GonzaloRomeroR/hexapod-robot/control/control.pdf

## Control din´amico

Se realiz´o el control din´amico del robot utilizando Simscape. El modelo completo puede observarse en la Figura 1. Los bloques trayectorias definen los perfiles de posiciones que debe seguir cada pata del robot. Cada una de las elementos(muslo, pierna y cuerpo del robot) poseen una masa y momento de inercia deteminado por las dimensiones de la estructura y ubicaciones de las masas involucradas. Se utilizan lazos PID como m´etodo de control de posici´on que pueden ser facilmente observados en la Figura 2.


Figure 1: Modelo din´amico total

1


Figure 2: Modelo din´amico de una pierna

2
