GonzaloRomeroR/hexapod-robot/dinamica/Dinamica.pdf

## Din´amica

Din´amica de forma anal´ıtica

1 | c l e a r
2 | c l c
3 | % Symbolic v a r i a b l e s
4 | syms l 1 l 2 l 3 ;
5 | syms q1 q2 q3 ;
6 | syms qd1 qd2 qd3 ;
7 | syms qdd1 qdd2 qdd3 ;
8 | syms l c 1 l c 2 l c 3 ;
9 | syms Ixx1 Ixx2 Ixx3 ;
10 | syms Iyy1 Iyy2 Iyy3 ;
11 | syms I z z 1 I z z 2 I z z 3 ;
12 | syms g ;
13 | syms m1 m2 m3;

14
15 | q = [ q1 q2 q3 ] ;
16 | qd = [ qd1 qd2 qd3 ] ;
17 | qdd = [ qdd1 qdd2 qdd3 ] ;

18
19 | % I n e r t i a
20 | % I 1 = [ Ixx1 , 0 , 0 ; 0 , Iyy1 , 0 ; 0 , 0 , I z z 1 ] ;
21 | % I 2 = [ Ixx2 , 0 , 0 ; 0 , Iyy2 , 0 ; 0 , 0 , I z z 2 ] ;
22 | % I 3 = [ Ixx3 , 0 , 0 ; 0 , Iyy3 , 0 ; 0 , 0 , I z z 3 ] ;

23
24 | I 1 = [ 0 , 0 , 0 ; 0 , 0 , 0 ; 0 , 0 , 0 ] ;
25 | I 2 = [ 0 , 0 , 0 ; 0 , 0 , 0 ; 0 , 0 , 0 ] ;
26 | I 3 = [ 0 , 0 , 0 ; 0 , 0 , 0 ; 0 , 0 , 0 ] ;

27

28
29 | % Link s
30 | L( 1 ) = Link ( [ 0 0 l 1 pi /2 0 ] ) ;
31 | L( 2 ) = Link ( [ 0 0 l 2 0 0 ] ) ;
32 | L( 3 ) = Link ([− pi /2 0 l 3 0 0 ] ) ;

33
34 | % Se t mass
35 | L( 1 ) .m = m1;
36 | L( 2 ) .m = m2;
37 | L( 3 ) .m = m3;

38
39 | % Se t i n e r t i a
40 | L( 1 ) . I = I 1 ;
41 | L( 2 ) . I = I 2 ;
42 | L( 3 ) . I = I 3 ;

1

43
44 | % L( 1 ) . r = [ l c 1 0 0 ] ;
45 | % L( 2 ) . r = [ l c 2 0 0 ] ;
46 | % L( 3 ) . r = [ l c 3 0 0 ] ;

47
48 | % Se t di s t a n c e t o c e n t e r o f mass
49 | L( 1 ) . r = [−(l 1−l c 1 ) 0 0 ] ;
50 | L( 2 ) . r = [−(l 2−l c 2 ) 0 0 ] ;
51 | L( 3 ) . r = [−(l 3−l c 3 ) 0 0 ] ;

52
53 | % Se t g e a r r e l a t i o n
54 | L( 1 ) .G = 1 ;
55 | L( 2 ) .G = 1 ;
56 | L( 3 ) .G = 1 ;

57
58 | % Se t motor i n e r t i a
59 | L( 1 ) .Jm = 0 ;
60 | L( 2 ) .Jm = 0 ;
61 | L( 3 ) .Jm = 0 ;

62
63 | % g r a vi t y and e x t e r i o r f o r c e s
64 | grav = [ 0 0 g ] ;
65 | f e x t =[0 0 0 0 0 0 ] ;

66
67 | % DH = [
68 | % 0 0 l 1 pi /2 0
69 | % 0 0 l 2 0 0
70 | % −pi /2 0 l 3 0 0
71 | % ] ;

72
73 | R = S e r i a l L i n k (L, ’name ’ , ’ l e g ’ ) ;
74 | % I n v e r s e dynamics
75 | % T = R. rne (q , qd , qdd , grav , f e x t ) ;
76 | % T( 1 )
77 | % T( 2 )
78 | % T( 3 )
79 | R. i n e r t i a ( q )
80 | R. g r a vi t y = [ 0 0 g ] ;
81 | R. g r a vl o a d ( q )
82 | R. c o r i o l i s (q , qd )

2
