GonzaloRomeroR/hexapod-robot/imagenes/axes.JPG

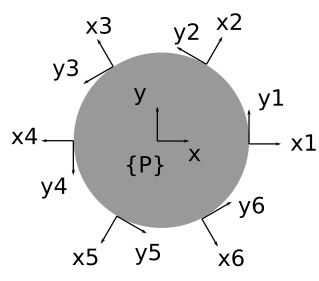
imagenes/axes.JPG
