GonzaloRomeroR/hexapod-robot/imagenes/bloquesSimscape.PNG

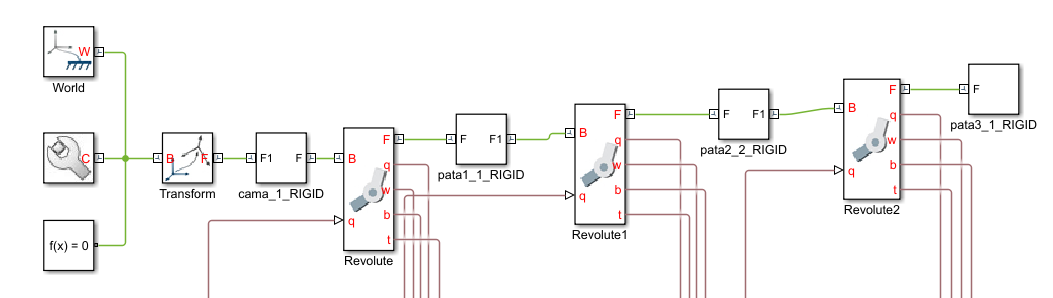
imagenes/bloquesSimscape.PNG
