GonzaloRomeroR/hexapod-robot/imagenes/control.jpg

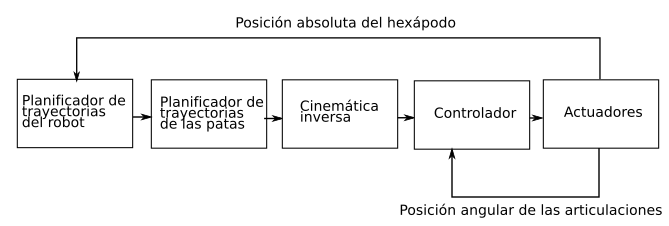
imagenes/control.jpg
