GonzaloRomeroR/hexapod-robot/imagenes/control_torque_1.JPG

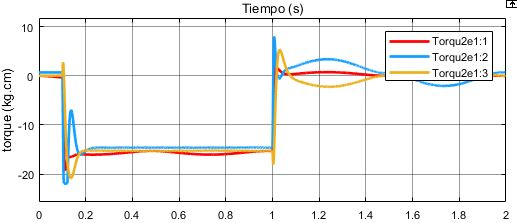
imagenes/control_torque_1.JPG
