GonzaloRomeroR/hexapod-robot/imagenes/corroboracion.PNG

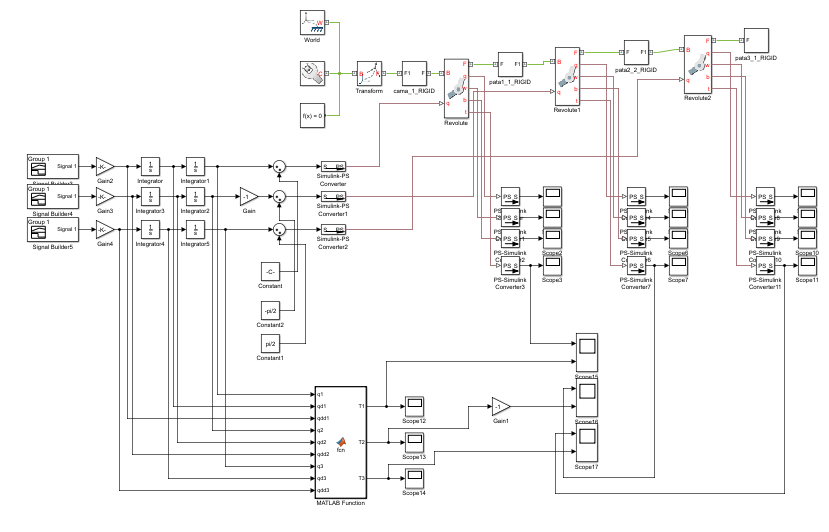
imagenes/corroboracion.PNG
