GonzaloRomeroR/hexapod-robot/imagenes/din2.png

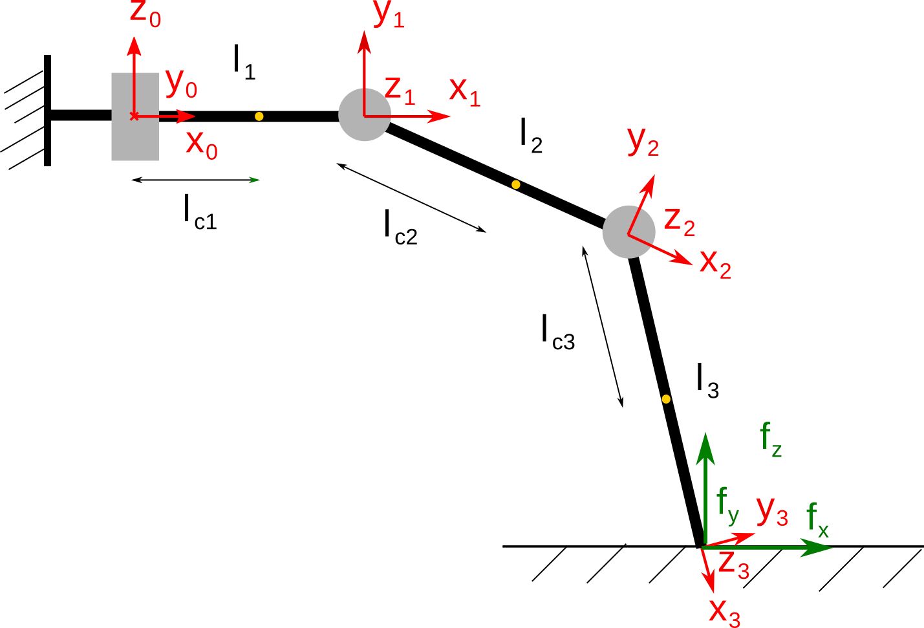
imagenes/din2.png
