GonzaloRomeroR/hexapod-robot/imagenes/din.svg.png

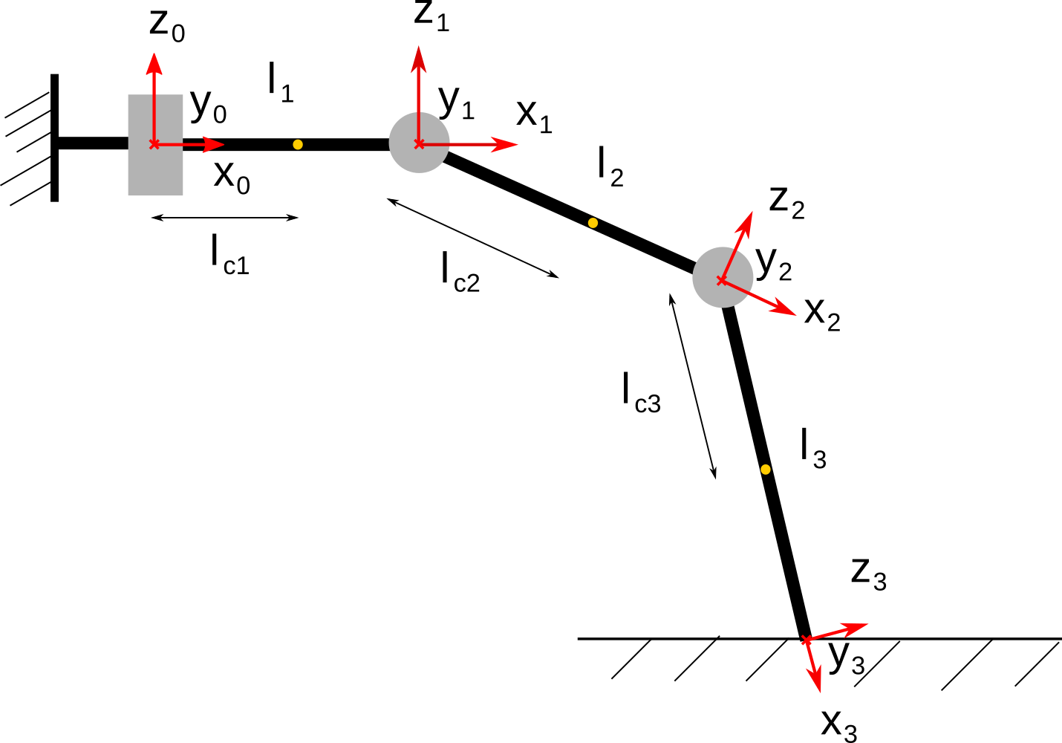
imagenes/din.svg.png
