GonzaloRomeroR/hexapod-robot/imagenes/esquema_hex.png

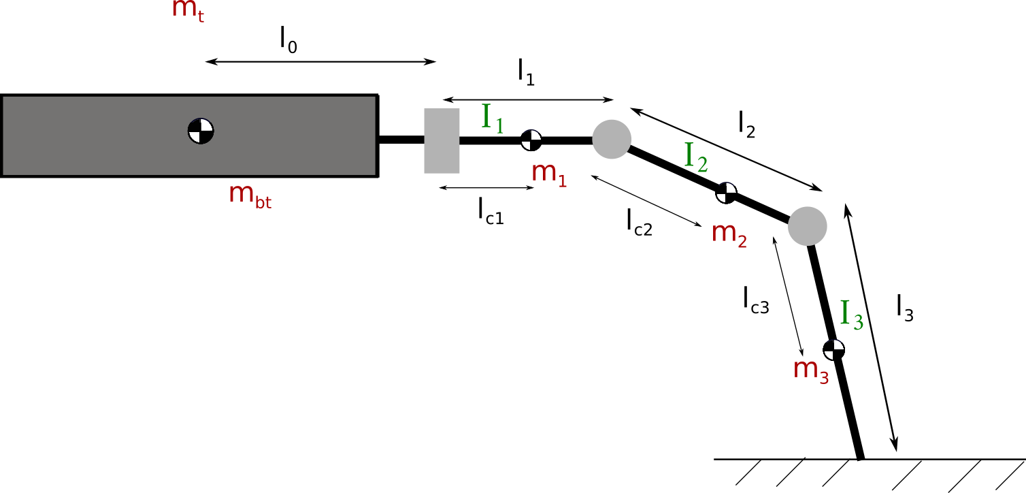
imagenes/esquema_hex.png
