GonzaloRomeroR/hexapod-robot/imagenes/hexapod_back.PNG

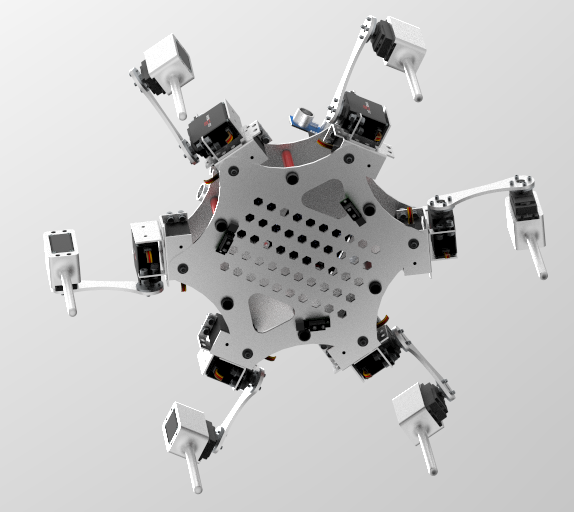
imagenes/hexapod_back.PNG
