GonzaloRomeroR/hexapod-robot/imagenes/hexapod_model2.PNG

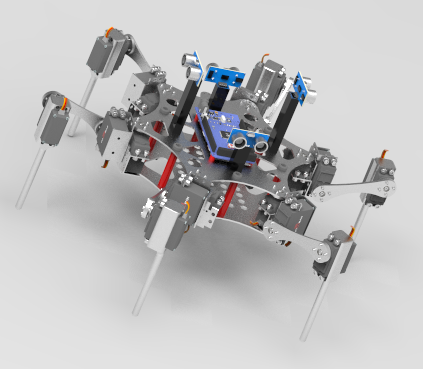
imagenes/hexapod_model2.PNG
