GonzaloRomeroR/hexapod-robot/imagenes/hexapod_model3.PNG

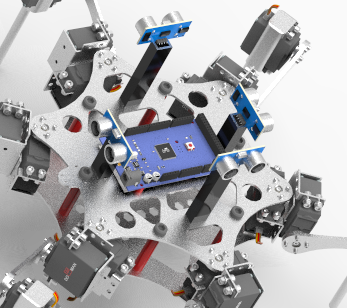
imagenes/hexapod_model3.PNG
