GonzaloRomeroR/hexapod-robot/imagenes/inverse_clarify.PNG

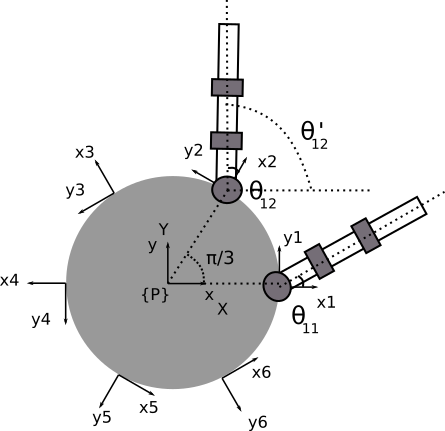
imagenes/inverse_clarify.PNG
