GonzaloRomeroR/hexapod-robot/imagenes/m_pos1.png

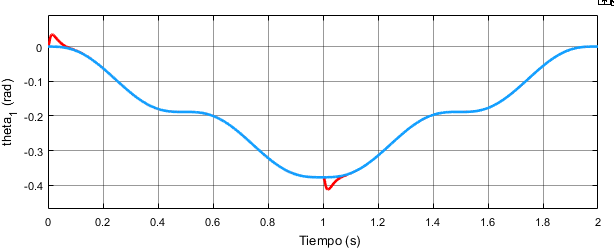
imagenes/m_pos1.png
