GonzaloRomeroR/hexapod-robot/imagenes/m_pos2 - copia.png

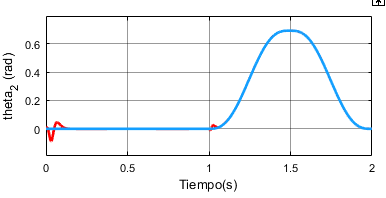
imagenes/m_pos2 - copia.png
