GonzaloRomeroR/hexapod-robot/imagenes/m_pos3.png

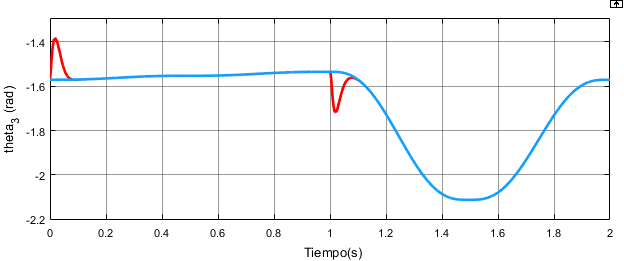
imagenes/m_pos3.png
