GonzaloRomeroR/hexapod-robot/imagenes/m_pos12 - copia.png

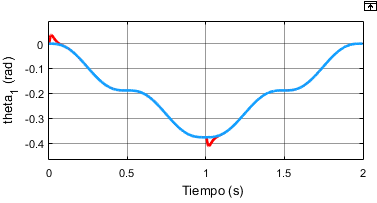
imagenes/m_pos12 - copia.png
