GonzaloRomeroR/hexapod-robot/imagenes/m_pos13.png

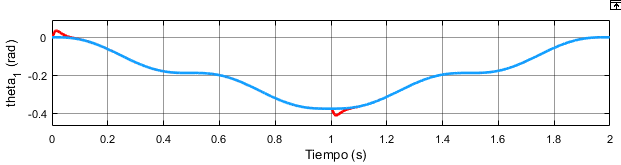
imagenes/m_pos13.png
