GonzaloRomeroR/hexapod-robot/imagenes/m_pos14.png

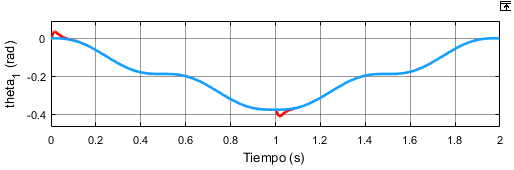
imagenes/m_pos14.png
