GonzaloRomeroR/hexapod-robot/imagenes/m_pos23.png

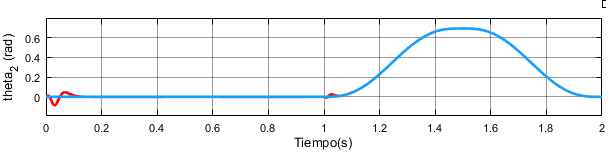
imagenes/m_pos23.png
