GonzaloRomeroR/hexapod-robot/imagenes/m_pos24.png

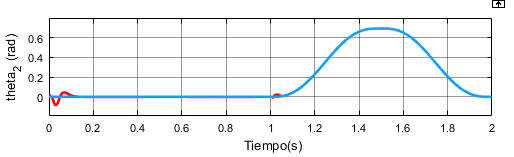
imagenes/m_pos24.png
