GonzaloRomeroR/hexapod-robot/imagenes/m_pos32 - copia.png

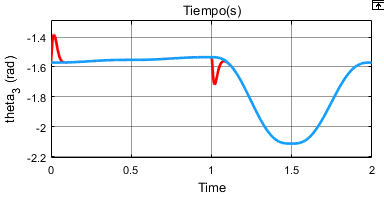
imagenes/m_pos32 - copia.png
