GonzaloRomeroR/hexapod-robot/imagenes/m_pos33.png

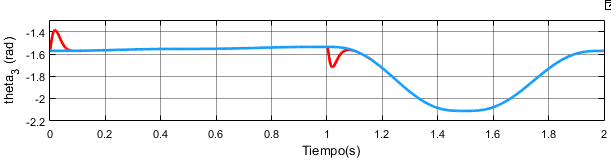
imagenes/m_pos33.png
