GonzaloRomeroR/hexapod-robot/imagenes/m_pos34.png

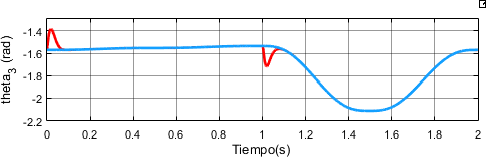
imagenes/m_pos34.png
