GonzaloRomeroR/hexapod-robot/imagenes/m_torque2.png

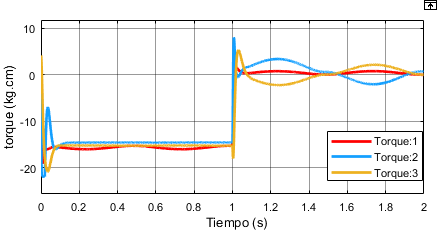
imagenes/m_torque2.png
