GonzaloRomeroR/hexapod-robot/imagenes/m_torque.JPG

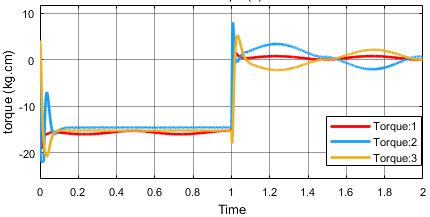
imagenes/m_torque.JPG
