GonzaloRomeroR/hexapod-robot/imagenes/m_torque.png

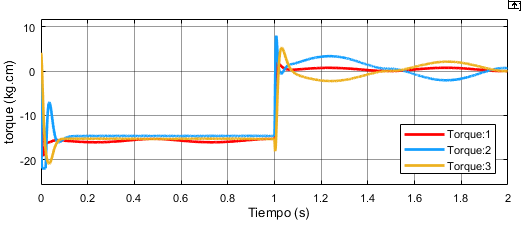
imagenes/m_torque.png
