GonzaloRomeroR/hexapod-robot/imagenes/mi_hex.PNG

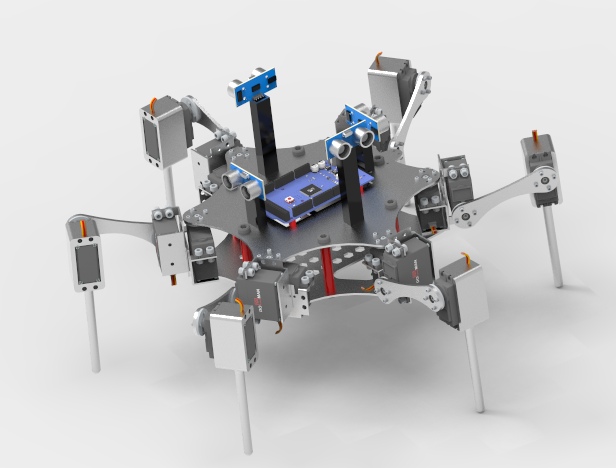
imagenes/mi_hex.PNG
