GonzaloRomeroR/hexapod-robot/imagenes/multiarticular.JPG

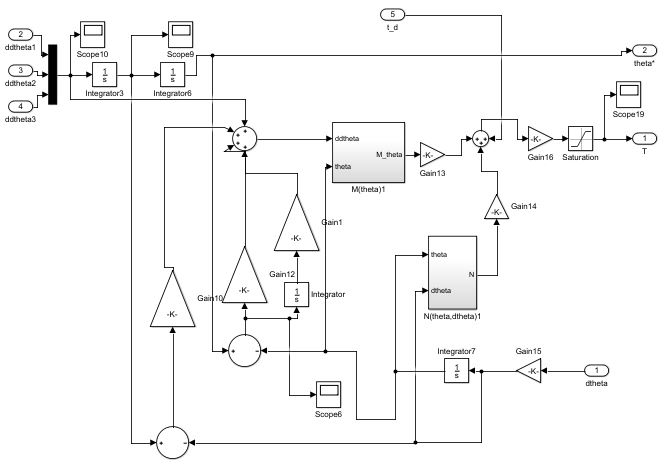
imagenes/multiarticular.JPG
