GonzaloRomeroR/hexapod-robot/imagenes/multiarticular.PNG

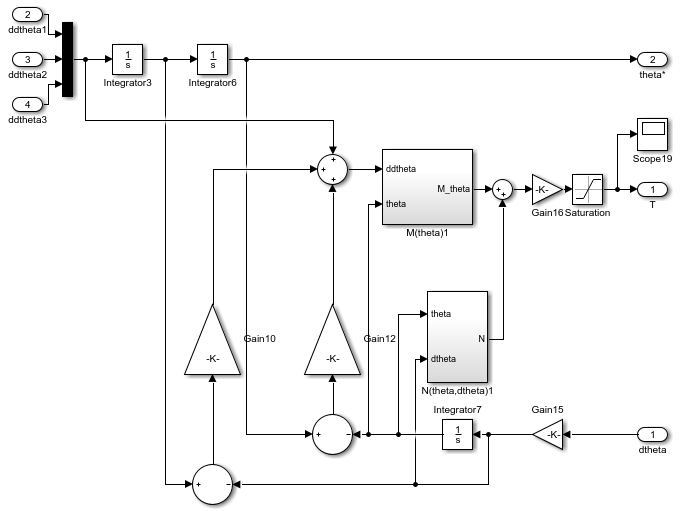
imagenes/multiarticular.PNG
