GonzaloRomeroR/hexapod-robot/imagenes/pata.PNG

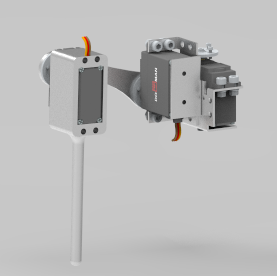
imagenes/pata.PNG
