GonzaloRomeroR/hexapod-robot/imagenes/signal_accerl.PNG

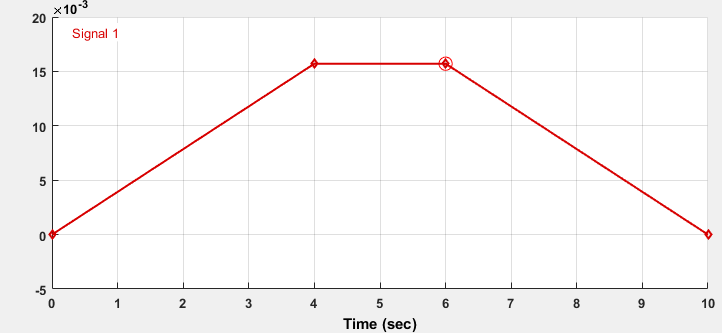
imagenes/signal_accerl.PNG
