GonzaloRomeroR/hexapod-robot/imagenes/sim1.PNG

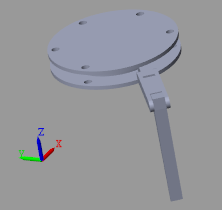
imagenes/sim1.PNG
