GonzaloRomeroR/hexapod-robot/imagenes/sim2.PNG

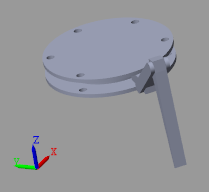
imagenes/sim2.PNG
