GonzaloRomeroR/hexapod-robot/imagenes/sim3.PNG

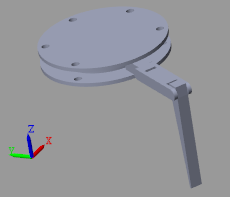
imagenes/sim3.PNG
