GonzaloRomeroR/hexapod-robot/imagenes/simscape.PNG

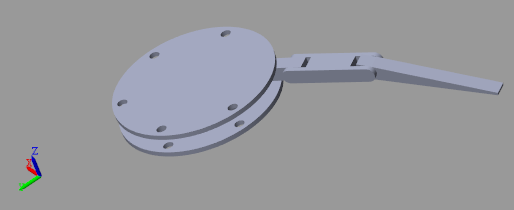
imagenes/simscape.PNG
