GonzaloRomeroR/hexapod-robot/imagenes/simscape_simulation.PNG

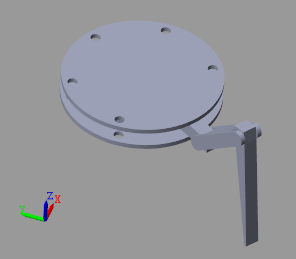
imagenes/simscape_simulation.PNG
