GonzaloRomeroR/hexapod-robot/imagenes/stability1.png

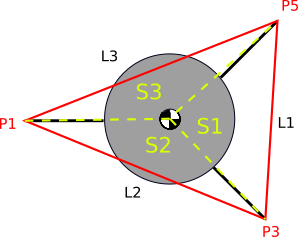
imagenes/stability1.png
