GonzaloRomeroR/hexapod-robot/imagenes/stability2.png

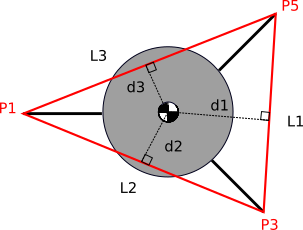
imagenes/stability2.png
