GonzaloRomeroR/hexapod-robot/imagenes/torque1.PNG

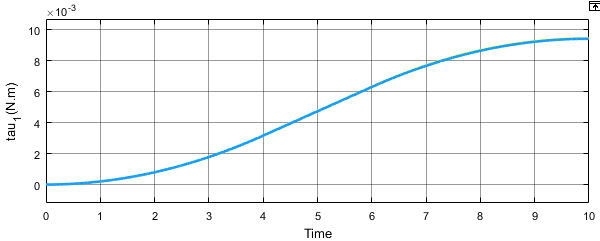
imagenes/torque1.PNG
