GonzaloRomeroR/hexapod-robot/imagenes/torque2.PNG

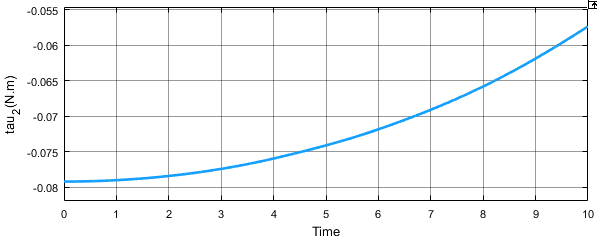
imagenes/torque2.PNG
