GonzaloRomeroR/hexapod-robot/imagenes/torque3.PNG

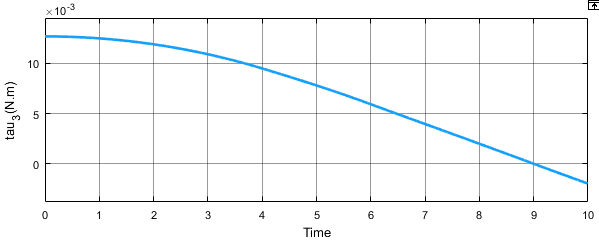
imagenes/torque3.PNG
