GonzaloRomeroR/hexapod-robot/simscape/simplify_model/simple_model.SLDASM

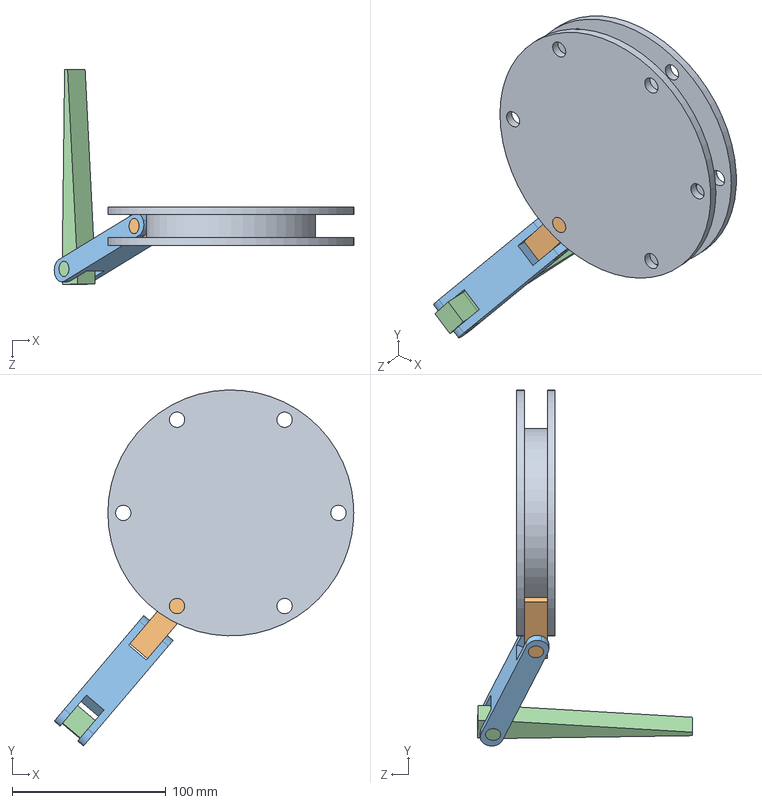
[picture p81: CAD file, 2019-07-20]
simscape/simplify_model/simple_model.SLDASM
194.9 x 231.6 x 140.0 mm
cama
pata1
pata2
pata3
