GonzaloRomeroR/hexapod-robot/diseño/Hexapodo3D_Agil/SensorSharpDigital/SensorSharpDigital.SLDASM

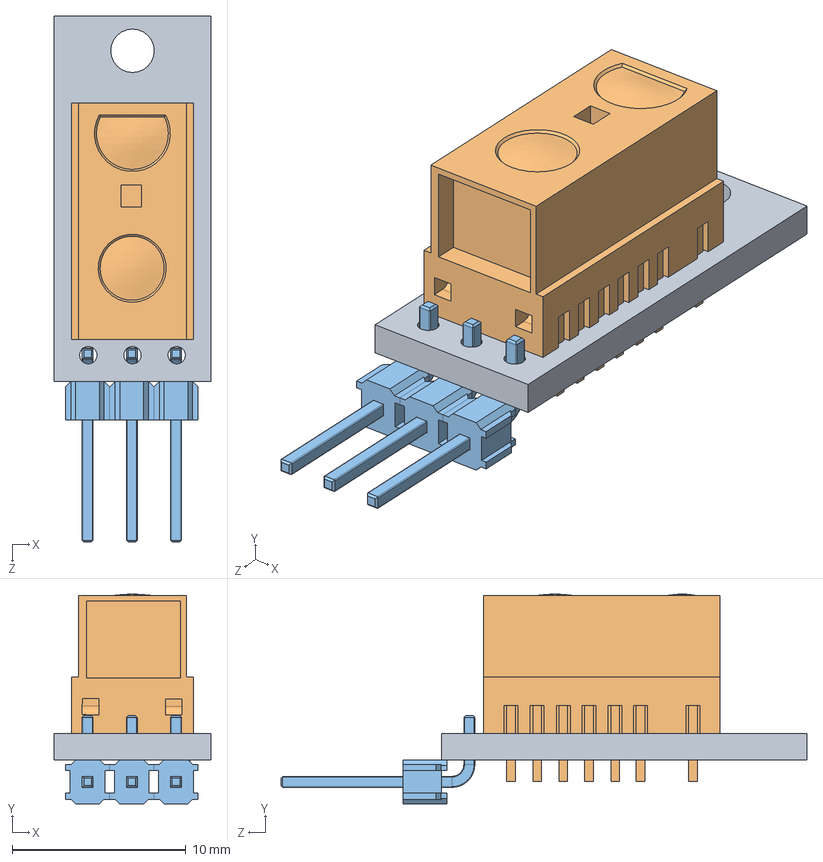
[picture p82: CAD file, 2019-07-20]
diseño/Hexapodo3D_Agil/SensorSharpDigital/SensorSharpDigital.SLDASM
9.00 x 12.1 x 30.2 mm
Base
GP2Y0D810Z0F sharp
PIN3Angulo
