GonzaloRomeroR/hexapod-robot/diseño/Hexapodo3D_Agil/DoMan DM-S2000MD.stp

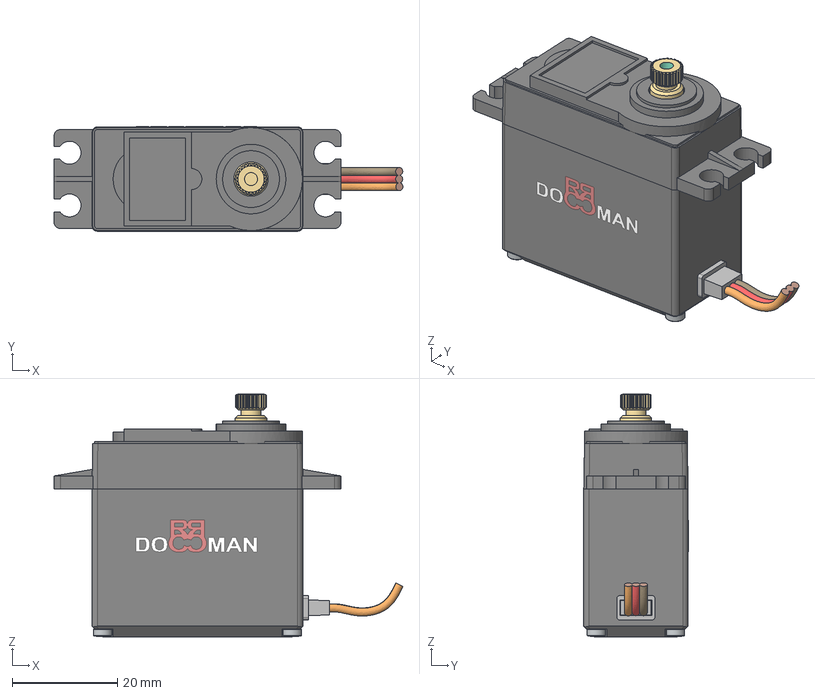
[picture p83: CAD file, 2019-07-20]
diseño/Hexapodo3D_Agil/DoMan DM-S2000MD.stp
66.2 x 19.8 x 46.0 mm
DM-S200MD Body
DM-S200MD Top Cap
Top Gear
Screw x 4
