GonzaloRomeroR/hexapod-robot/diseño/Hexapodo3D_Agil/SensorSharpDigital/Base.SLDPRT

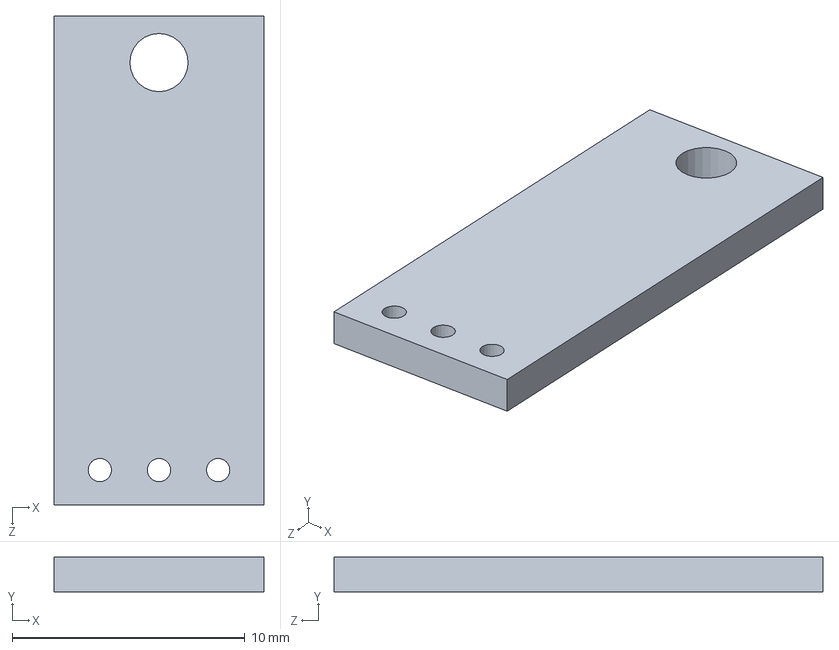
[picture p84: CAD file, 2019-07-20]
diseño/Hexapodo3D_Agil/SensorSharpDigital/Base.SLDPRT
9.00 x 1.50 x 21.0 mm
