GonzaloRomeroR/hexapod-robot/simscape/simplify_model/pata1_Predeterminado_sldprt.STEP

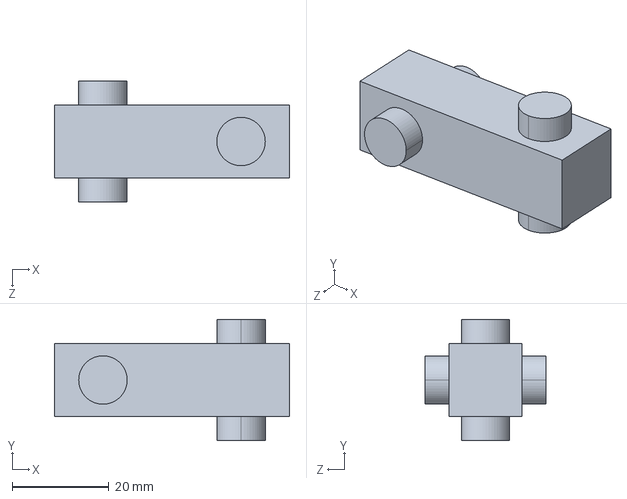
[picture p85: CAD file, 2019-07-20]
simscape/simplify_model/pata1_Predeterminado_sldprt.STEP
48.5 x 25.0 x 25.0 mm
