GonzaloRomeroR/hexapod-robot/diseño/Hexapodo3D_Agil/SensorSharpDigital/GP2Y0D810Z0F sharp.SLDPRT

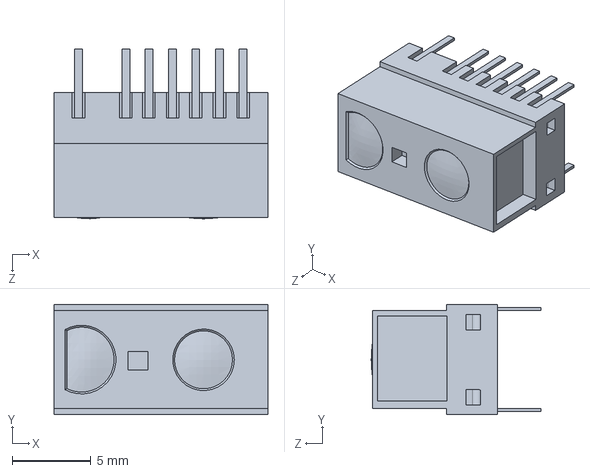
[picture p86: CAD file, 2019-07-20]
diseño/Hexapodo3D_Agil/SensorSharpDigital/GP2Y0D810Z0F sharp.SLDPRT
13.6 x 7.00 x 10.8 mm
