GonzaloRomeroR/hexapod-robot/simscape/simplify_model/pata3_Predeterminado_sldprt.STEP

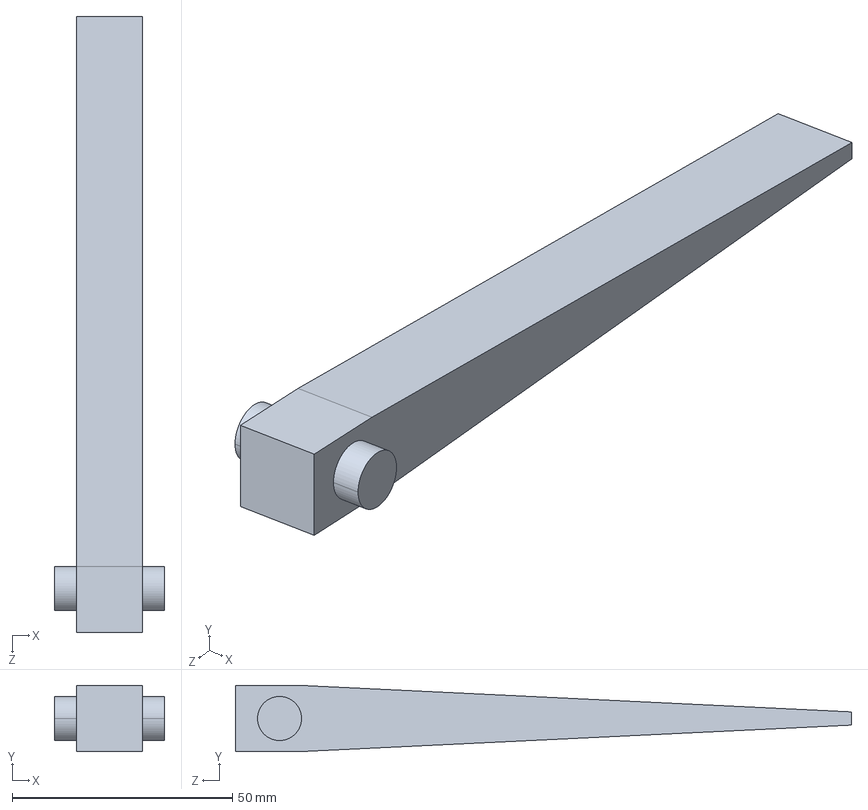
[picture p87: CAD file, 2019-07-20]
simscape/simplify_model/pata3_Predeterminado_sldprt.STEP
25.0 x 15.0 x 139.8 mm
