GonzaloRomeroR/hexapod-robot/diseño/Hexapodo3D_Agil/SensorSharpDigital/PIN3Angulo.SLDPRT

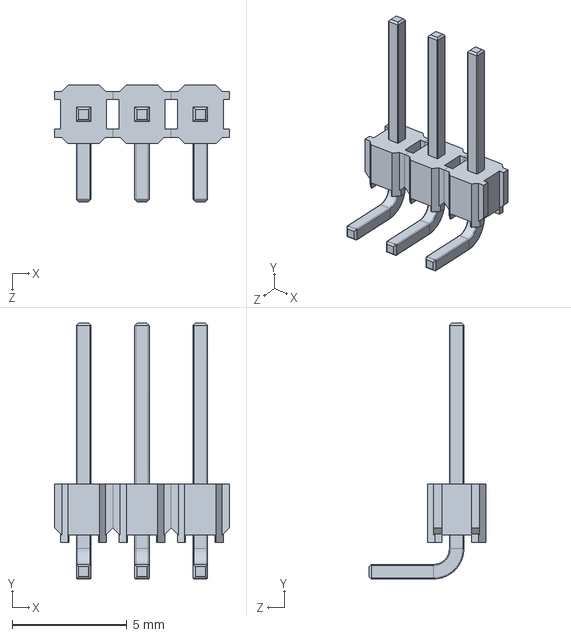
[picture p88: CAD file, 2019-07-20]
diseño/Hexapodo3D_Agil/SensorSharpDigital/PIN3Angulo.SLDPRT
7.62 x 11.1 x 5.08 mm
