GonzaloRomeroR/hexapod-robot/simscape/simplify_model/pata2_Predeterminado_sldprt.STEP

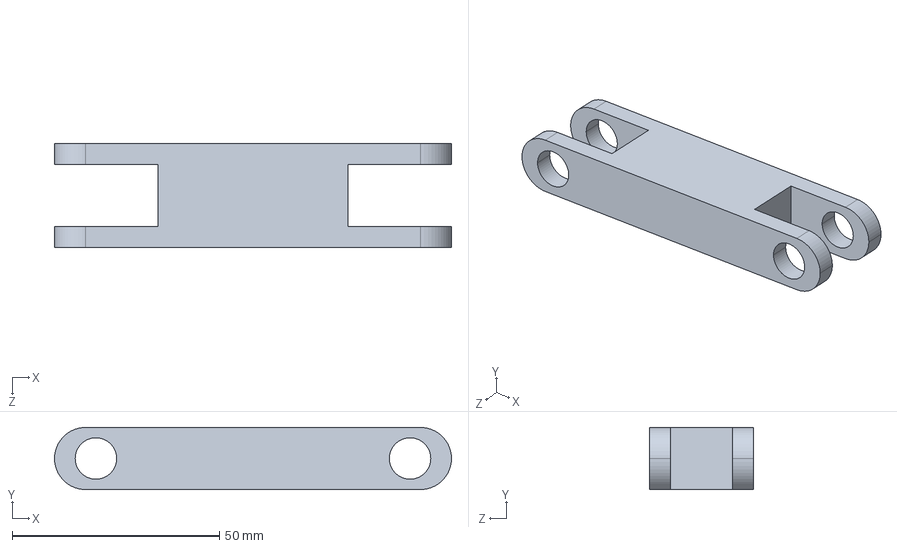
[picture p89: CAD file, 2019-07-20]
simscape/simplify_model/pata2_Predeterminado_sldprt.STEP
95.8 x 15.0 x 25.0 mm
