GonzaloRomeroR/hexapod-robot/simscape/simplify_model/cama_Predeterminado_sldprt.STEP

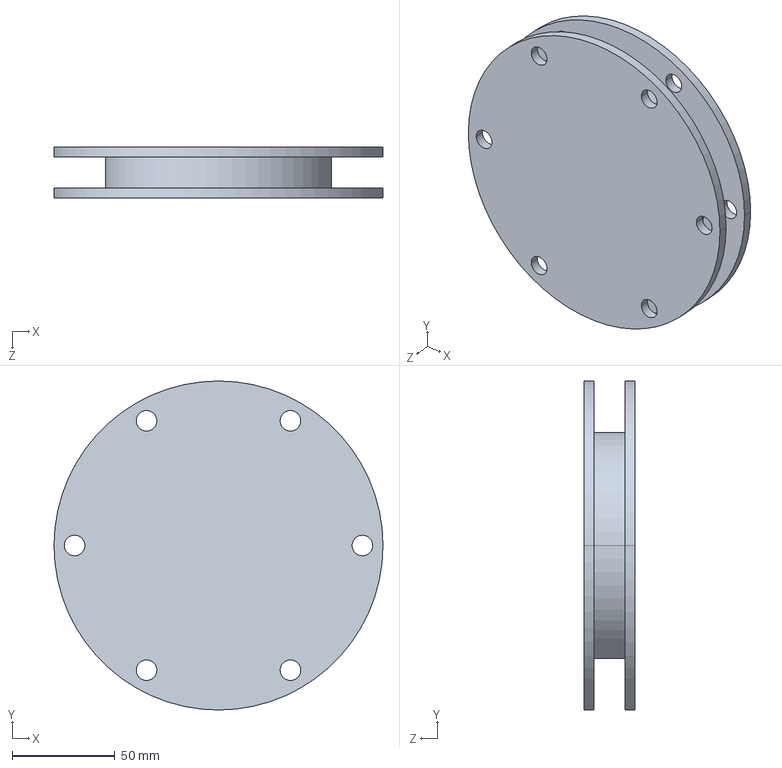
[picture p90: CAD file, 2019-07-20]
simscape/simplify_model/cama_Predeterminado_sldprt.STEP
160.0 x 160.0 x 25.0 mm
