GonzaloRomeroR/hexapod-robot/(list of files, cad)

Other CAD files:
diseño/Hexapodo3D_Agil/DoMan DM-S2000MD.x_t
