GonzaloRomeroR/hexapod-robot/imagenes/control_test_1.JPG

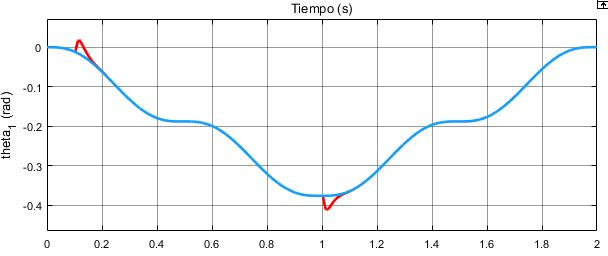
imagenes/control_test_1.JPG
