GonzaloRomeroR/hexapod-robot/imagenes/control_test_2.JPG

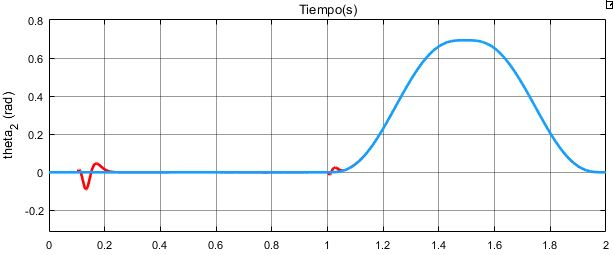
imagenes/control_test_2.JPG
