GonzaloRomeroR/hexapod-robot/imagenes/control_test_3.JPG

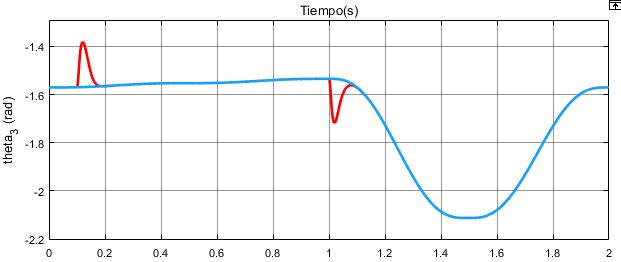
imagenes/control_test_3.JPG
