GonzaloRomeroR/hexapod-robot/(list of files, drawings)

Other design files:
code/conections.fzz
