GonzaloRomeroR/hexapod-robot/(commit log)

2019-06-27 Papers added
    [conections.fzz]
2019-07-20 Dynamics leg control finished for random mass
    [Base+Eslabones+Motores.cfg, Base.SLDPRT, Base.cfg, DoMan DM-S2000MD.cfg, DoMan DM-S2000MD.stp, DoMan DM-S2000MD.x_t, Esla3.cfg, Eslabon1.cfg]
